LoPalma/4332-cpu/basys3.xdc

# =============================================================================
# Basys 3 (Artix-7 xc7a35tcpg236-1) — 4332 CPU constraints
# =============================================================================

# -----------------------------------------------------------------------------
# Clock — 100 MHz board oscillator
# -----------------------------------------------------------------------------
set_property -dict {PACKAGE_PIN W5  IOSTANDARD LVCMOS33} [get_ports clk]
create_clock -period 10.000 -name sys_clk_pin -waveform {0.000 5.000} -add [get_ports clk]

# -----------------------------------------------------------------------------
# Buttons
# BTNU (T18) — reset (press to hold CPU in reset)
# BTNC (U18) — step  (each press advances CPU by one clock cycle)
# -----------------------------------------------------------------------------
set_property -dict {PACKAGE_PIN T18 IOSTANDARD LVCMOS33} [get_ports reset]
set_property -dict {PACKAGE_PIN U18 IOSTANDARD LVCMOS33} [get_ports step]

# -----------------------------------------------------------------------------
# 16 LEDs — show current instruction word (idata)
# -----------------------------------------------------------------------------
set_property -dict {PACKAGE_PIN U16 IOSTANDARD LVCMOS33} [get_ports {led[0]}]
set_property -dict {PACKAGE_PIN E19 IOSTANDARD LVCMOS33} [get_ports {led[1]}]
set_property -dict {PACKAGE_PIN U19 IOSTANDARD LVCMOS33} [get_ports {led[2]}]
set_property -dict {PACKAGE_PIN V19 IOSTANDARD LVCMOS33} [get_ports {led[3]}]
set_property -dict {PACKAGE_PIN W18 IOSTANDARD LVCMOS33} [get_ports {led[4]}]
set_property -dict {PACKAGE_PIN U15 IOSTANDARD LVCMOS33} [get_ports {led[5]}]
set_property -dict {PACKAGE_PIN U14 IOSTANDARD LVCMOS33} [get_ports {led[6]}]
set_property -dict {PACKAGE_PIN V14 IOSTANDARD LVCMOS33} [get_ports {led[7]}]
set_property -dict {PACKAGE_PIN V13 IOSTANDARD LVCMOS33} [get_ports {led[8]}]
set_property -dict {PACKAGE_PIN V3  IOSTANDARD LVCMOS33} [get_ports {led[9]}]
set_property -dict {PACKAGE_PIN W3  IOSTANDARD LVCMOS33} [get_ports {led[10]}]
set_property -dict {PACKAGE_PIN U3  IOSTANDARD LVCMOS33} [get_ports {led[11]}]
set_property -dict {PACKAGE_PIN P3  IOSTANDARD LVCMOS33} [get_ports {led[12]}]
set_property -dict {PACKAGE_PIN N3  IOSTANDARD LVCMOS33} [get_ports {led[13]}]
set_property -dict {PACKAGE_PIN P1  IOSTANDARD LVCMOS33} [get_ports {led[14]}]
set_property -dict {PACKAGE_PIN L1  IOSTANDARD LVCMOS33} [get_ports {led[15]}]

# -----------------------------------------------------------------------------
# 7-Segment Display — shows PC (iaddr)
# -----------------------------------------------------------------------------
set_property -dict {PACKAGE_PIN W7 IOSTANDARD LVCMOS33} [get_ports {seg[0]}]
set_property -dict {PACKAGE_PIN W6 IOSTANDARD LVCMOS33} [get_ports {seg[1]}]
set_property -dict {PACKAGE_PIN U8 IOSTANDARD LVCMOS33} [get_ports {seg[2]}]
set_property -dict {PACKAGE_PIN V8 IOSTANDARD LVCMOS33} [get_ports {seg[3]}]
set_property -dict {PACKAGE_PIN U5 IOSTANDARD LVCMOS33} [get_ports {seg[4]}]
set_property -dict {PACKAGE_PIN V5 IOSTANDARD LVCMOS33} [get_ports {seg[5]}]
set_property -dict {PACKAGE_PIN U7 IOSTANDARD LVCMOS33} [get_ports {seg[6]}]

set_property -dict {PACKAGE_PIN U2 IOSTANDARD LVCMOS33} [get_ports {an[0]}]
set_property -dict {PACKAGE_PIN U4 IOSTANDARD LVCMOS33} [get_ports {an[1]}]
set_property -dict {PACKAGE_PIN V4 IOSTANDARD LVCMOS33} [get_ports {an[2]}]
set_property -dict {PACKAGE_PIN W4 IOSTANDARD LVCMOS33} [get_ports {an[3]}]

# -----------------------------------------------------------------------------
# Switches — reserved for future manual instruction loading
# -----------------------------------------------------------------------------
# set_property -dict {PACKAGE_PIN V17 IOSTANDARD LVCMOS33} [get_ports {sw[0]}]
# set_property -dict {PACKAGE_PIN V16 IOSTANDARD LVCMOS33} [get_ports {sw[1]}]
# set_property -dict {PACKAGE_PIN W16 IOSTANDARD LVCMOS33} [get_ports {sw[2]}]
# set_property -dict {PACKAGE_PIN W17 IOSTANDARD LVCMOS33} [get_ports {sw[3]}]
# set_property -dict {PACKAGE_PIN W15 IOSTANDARD LVCMOS33} [get_ports {sw[4]}]
# set_property -dict {PACKAGE_PIN V15 IOSTANDARD LVCMOS33} [get_ports {sw[5]}]
# set_property -dict {PACKAGE_PIN W14 IOSTANDARD LVCMOS33} [get_ports {sw[6]}]
# set_property -dict {PACKAGE_PIN W13 IOSTANDARD LVCMOS33} [get_ports {sw[7]}]
# set_property -dict {PACKAGE_PIN V2  IOSTANDARD LVCMOS33} [get_ports {sw[8]}]
# set_property -dict {PACKAGE_PIN T3  IOSTANDARD LVCMOS33} [get_ports {sw[9]}]
# set_property -dict {PACKAGE_PIN T2  IOSTANDARD LVCMOS33} [get_ports {sw[10]}]
# set_property -dict {PACKAGE_PIN R3  IOSTANDARD LVCMOS33} [get_ports {sw[11]}]
# set_property -dict {PACKAGE_PIN W2  IOSTANDARD LVCMOS33} [get_ports {sw[12]}]
# set_property -dict {PACKAGE_PIN U1  IOSTANDARD LVCMOS33} [get_ports {sw[13]}]
# set_property -dict {PACKAGE_PIN T1  IOSTANDARD LVCMOS33} [get_ports {sw[14]}]
# set_property -dict {PACKAGE_PIN R2  IOSTANDARD LVCMOS33} [get_ports {sw[15]}]

# -----------------------------------------------------------------------------
# Other buttons — available for future use
# BTNL (W19), BTNR (T17), BTND (U17)
# -----------------------------------------------------------------------------
# set_property -dict {PACKAGE_PIN W19 IOSTANDARD LVCMOS33} [get_ports btnL]
# set_property -dict {PACKAGE_PIN T17 IOSTANDARD LVCMOS33} [get_ports btnR]
# set_property -dict {PACKAGE_PIN U17 IOSTANDARD LVCMOS33} [get_ports btnD]
