LoPalma/4332-cpu/(commit log)

2026-04-14 First commit: tests fail, but core logic is implemented
    [cpu.vhd, cpu_tb.vhd, memory.vhd, memory_bus.vhd, peripherals.vhd]
2026-04-21 Fixed bug in RIC reading
    [cpu.vhd, top.vhd]
